deviousprophet/Smarthome_Zigbee/BaoCao/pictures/hub.jpg

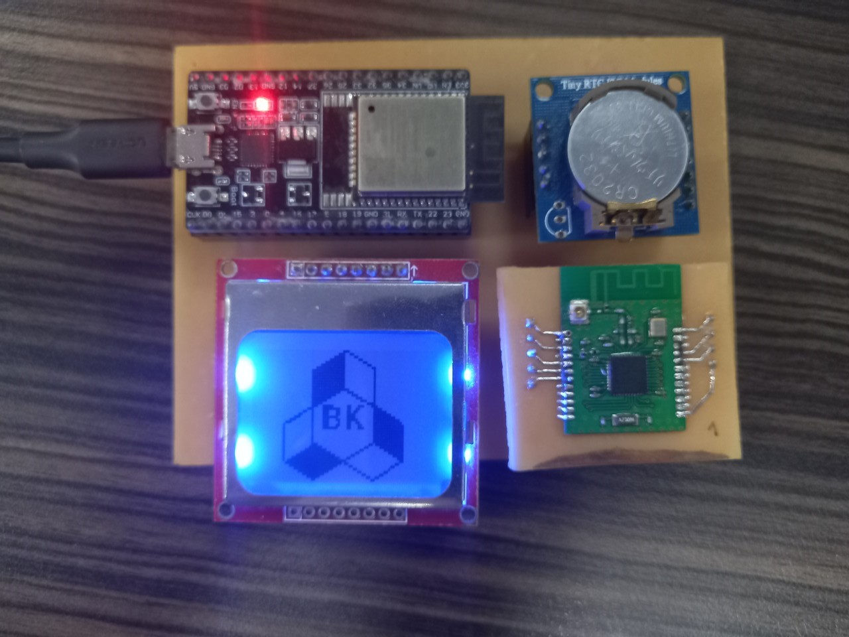
BaoCao/pictures/hub.jpg
