deviousprophet/Smarthome_Zigbee/BaoCao/pictures/relay3.jpg

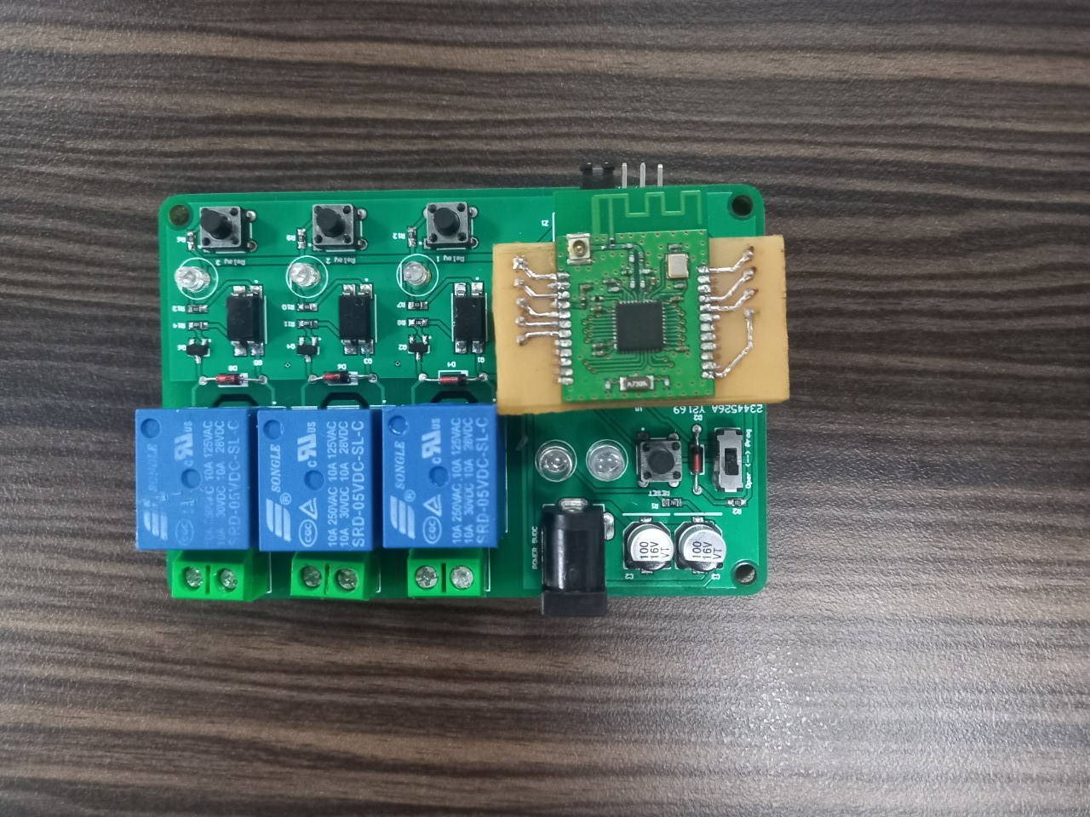
BaoCao/pictures/relay3.jpg
