deviousprophet/Smarthome_Zigbee/pcb/sz1v5/sz1v5_pinout.pdf

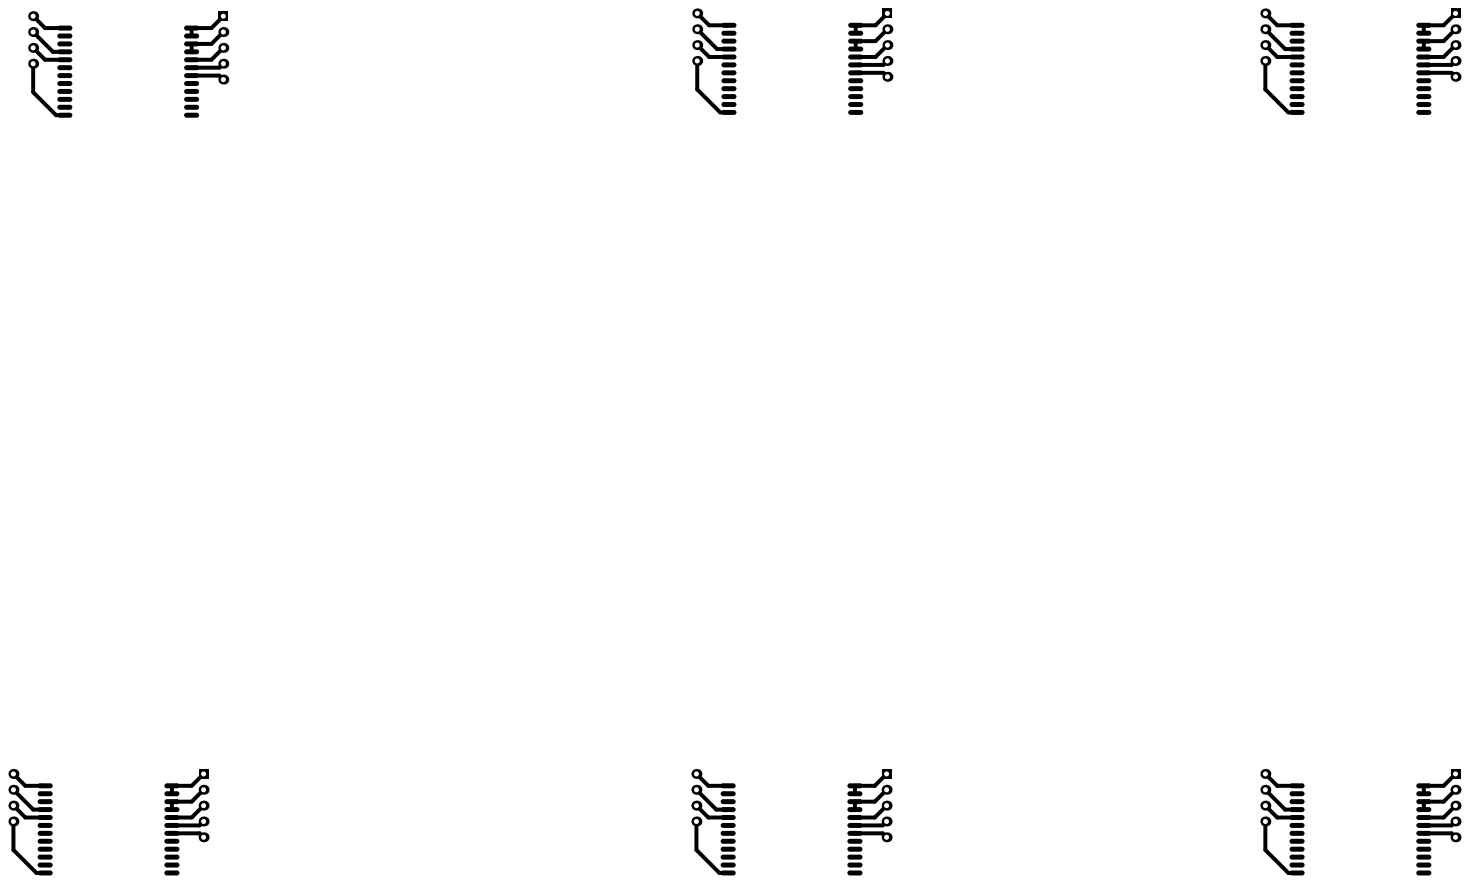
[picture p3: page 1]
