deviousprophet/Smarthome_Zigbee/BaoCao/pictures/button.jpg

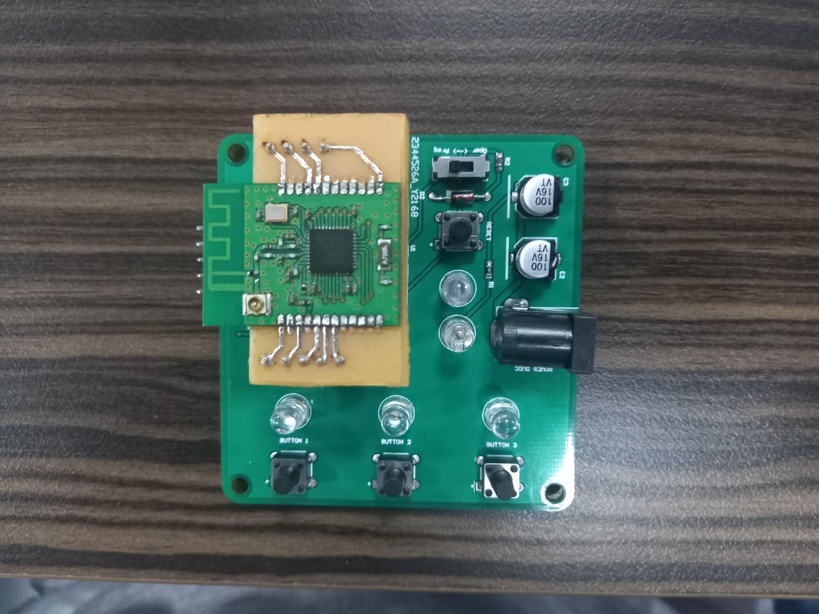
BaoCao/pictures/button.jpg
