deviousprophet/Smarthome_Zigbee/BaoCao/pictures/relay_ade.jpg

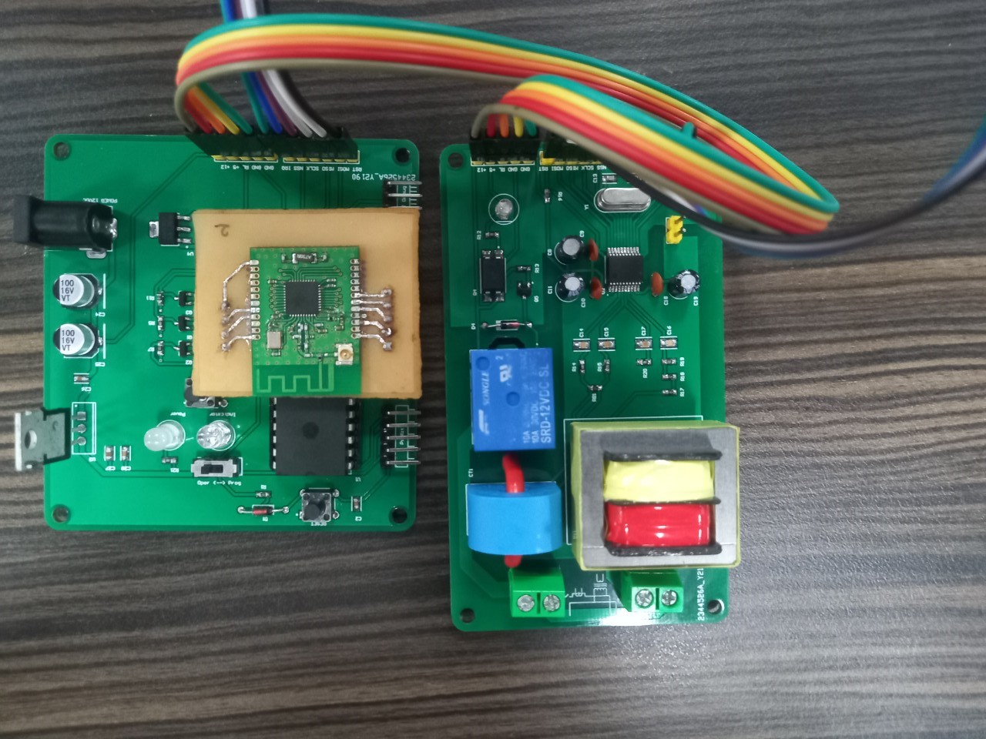
BaoCao/pictures/relay_ade.jpg
