deviousprophet/Smarthome_Zigbee/BaoCao/pictures/sensor.jpg

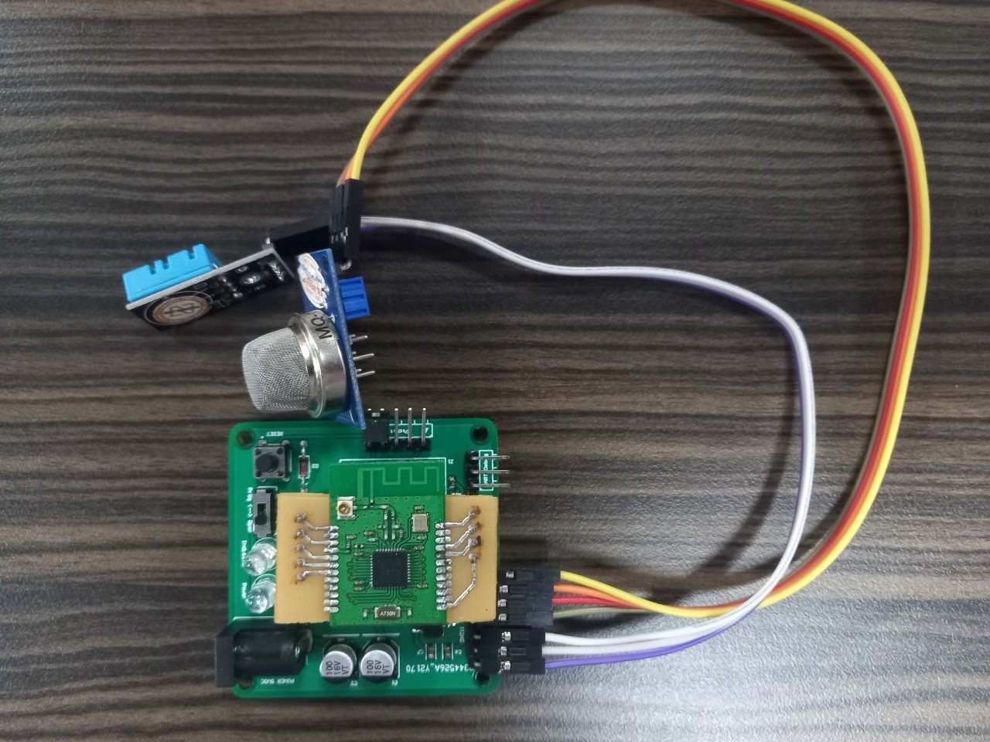
BaoCao/pictures/sensor.jpg
