deviousprophet/Smarthome_Zigbee/source/calibration.xlsx

Sheet: vrms
V1 | 73232 | 25.1 | Vrms1 |  |  | 10632 | 0.204
V2 | 709708 | 249.9 | Vrms2 |  | I1 | 235678 | 4.49 | rms1
VRMSOS | 0.7651600375
IRMSOS | -1.796884521e-08
 |  |  | <200 | >= 200 |  | 0.0003435000542 | -0.7331922115 |  | 2911.207692
ade | MFM383A |  | 0.0003416507375 | 0.0003461786731 |  | 0.0003780683047 | -20.25007624 |  | 2645.024689
292308 | 99.9 | 0.0003417627981 |  |  | 99.86724377 | 0.03278901776 |  | 99.67462163 | 0.2256039729
351490 | 119.9 | 0.0003411192353 |  |  | 120.0868177 | 0.1558112734 |  | 120.0036418 | 0.08644023238
411180 | 140.3 | 0.000341213094 |  |  | 140.4799502 | 0.1282610385 |  | 140.5071601 | 0.1476550775
468181 | 159.9 | 0.0003415345774 |  |  | 159.9543839 | 0.03401120953 |  | 160.0870067 | 0.1169522596
525941 | 180.2 | 0.0003426239825 |  |  | 179.6881305 | 0.2840563147 |  | 179.9275698 | 0.1511821346
583004 | 200.4 | 0.0003437369212 |  |  | 201.8235511 | 0.710354851 |  | 200.1652577 | 0.1171369002
612079 | 211.1 | 0.0003448901204 |  |  | 211.888696 | 0.3736125254 |  | 211.1575936 | 0.02728261973
635744 | 219.8 | 0.0003457366487 |  |  | 220.0810143 | 0.127850018 |  | 220.10458 | 0.1385714469
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
