deviousprophet/Smarthome_Zigbee/BaoCao/ThamKhao/iHome/LVTN.pdf

# TÌM HIỂU, THIẾT KẾ VÀ THI

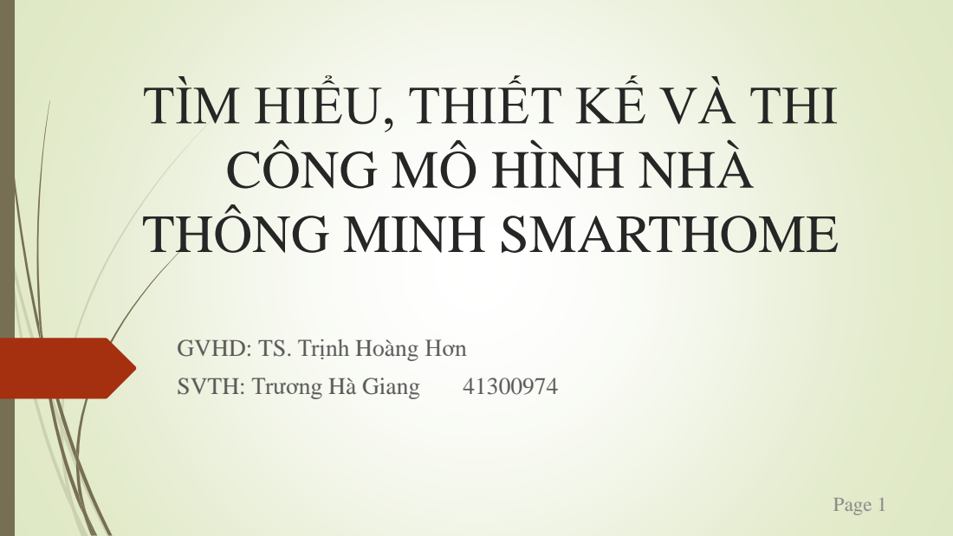
[picture p97: page 1]
SVTH: Trương Hà Giang

CÔNG MÔ HÌNH NHÀ
THÔNG MINH SMARTHOME

GVHD: TS. Trịnh Hoàng Hơn

# Nội dung

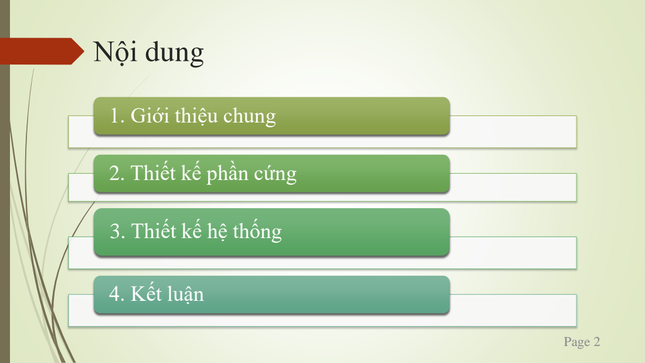
[picture p98: page 2]
4. Kết luận

1. Giới thiệu chung

2. Thiết kế phần cứng

3. Thiết kế hệ thống

## Giới thiệu chung

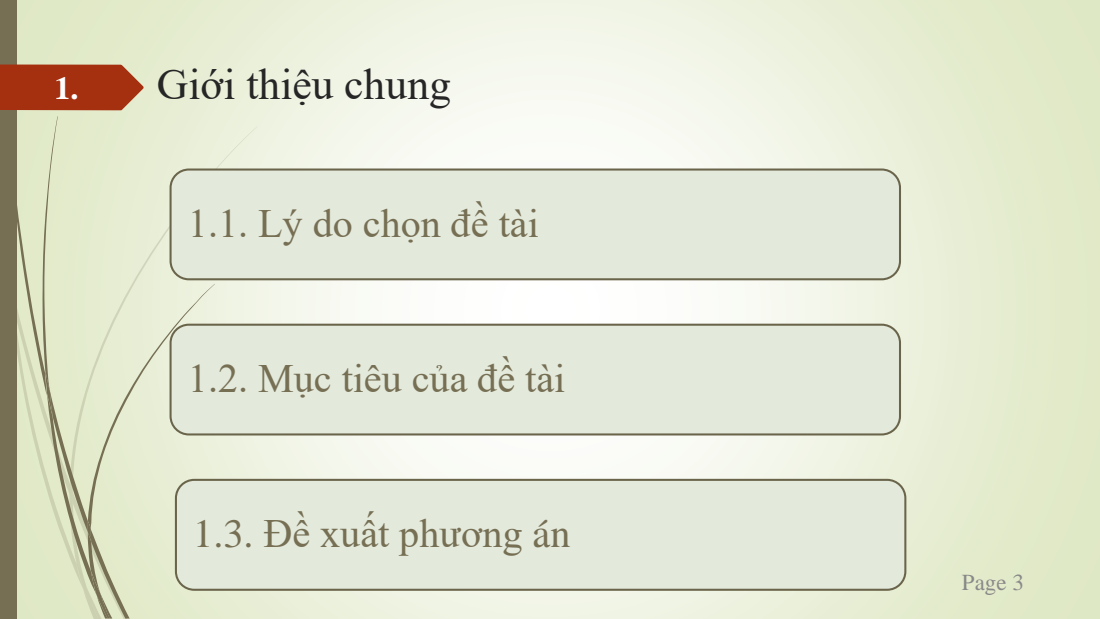
[picture p99: page 3]

1.1. Lý do chọn đề tài

1.2. Mục tiêu của đề tài

1.3. Đề xuất phương án

## 1.1. Lý do chọn đề tài

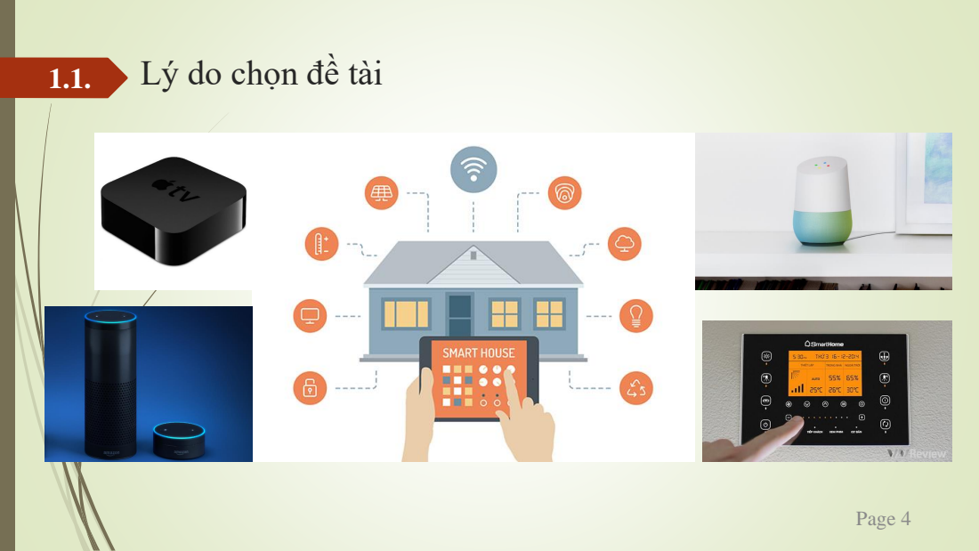
[picture p100: page 4]

## 1.2. Mục tiêu của đề tài

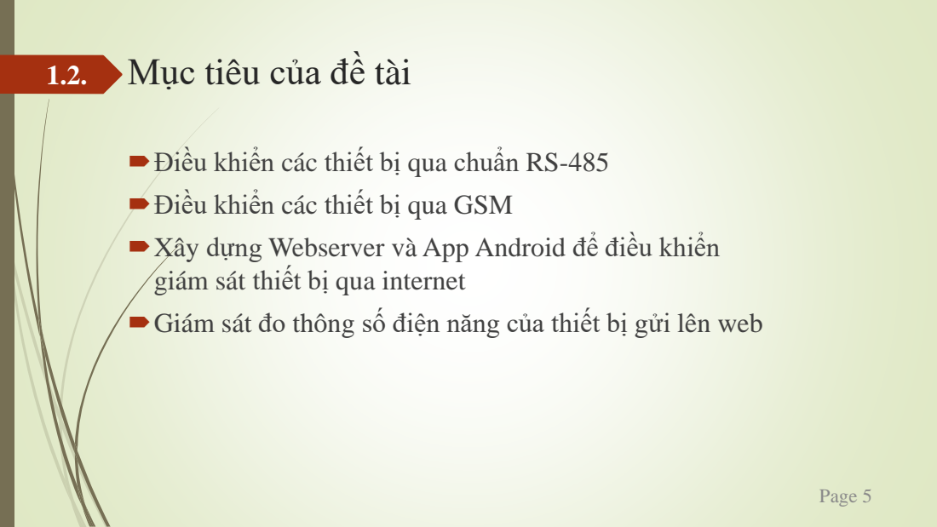
[picture p101: page 5]

Điều khiển các thiết bị qua chuẩn RS-485
Điều khiển các thiết bị qua GSM
Xây dựng Webserver và App Android để điều khiển
giám sát thiết bị qua internet
Giám sát đo thông số điện năng của thiết bị gửi lên web

## 1.3. Đề xuất phương án

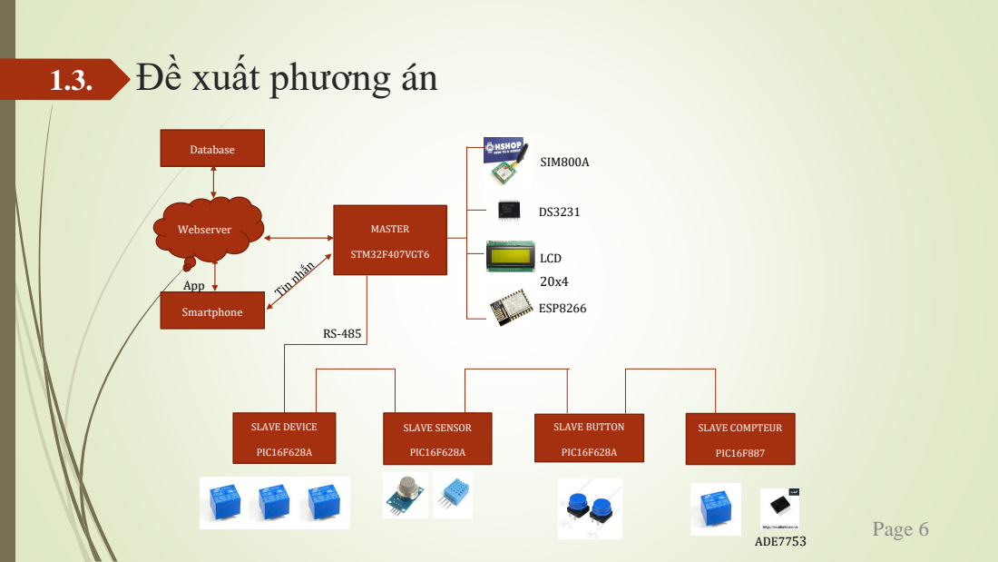
[picture p102: page 6]
ADE7753; SIM800A; LCD; ESP8266; MASTER; STM32F407VGT6; SLAVE BUTTON; PIC16F628A; SLAVE DEVICE; SLAVE SENSOR; SLAVE COMPTEUR; PIC16F887; Webserver; Database; Smartphone; App

## 2. Thiết kế phần cứng

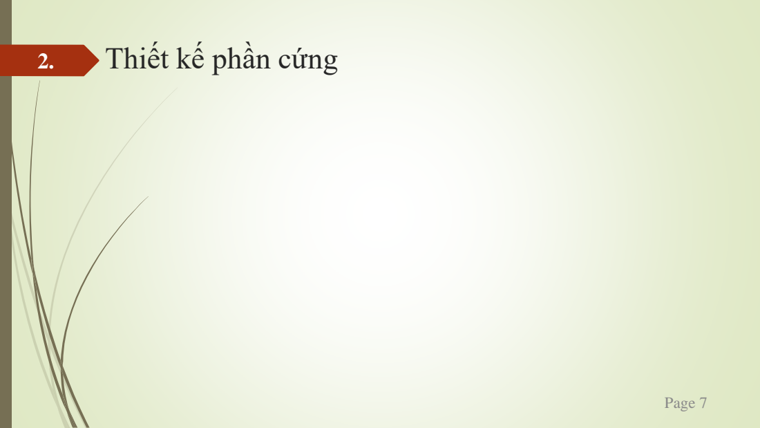
[picture p103: page 7]

## 2.1. Thiết kế mạch Master

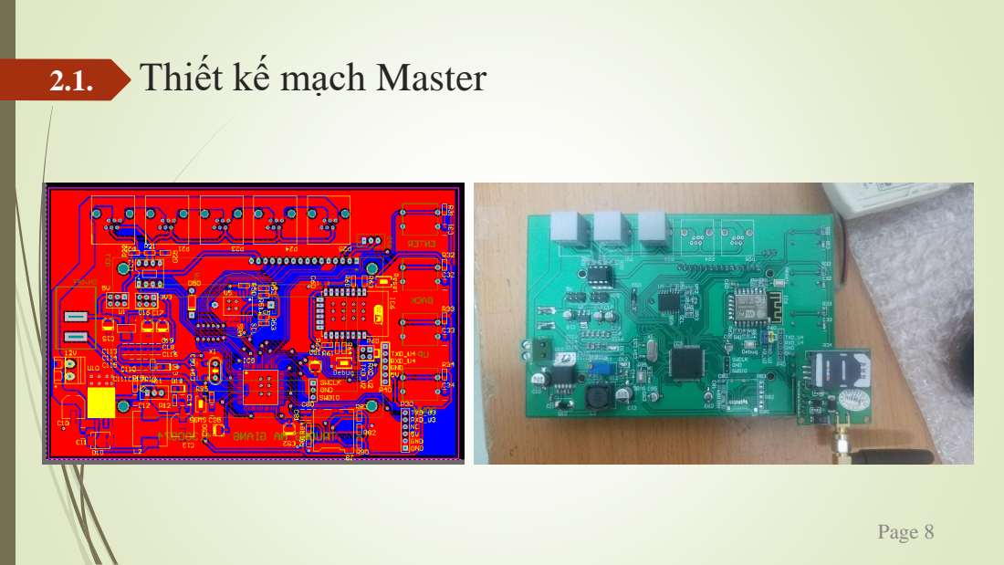
[picture p104: page 8]

## 2.2. Thiết kế mạch Slave Button

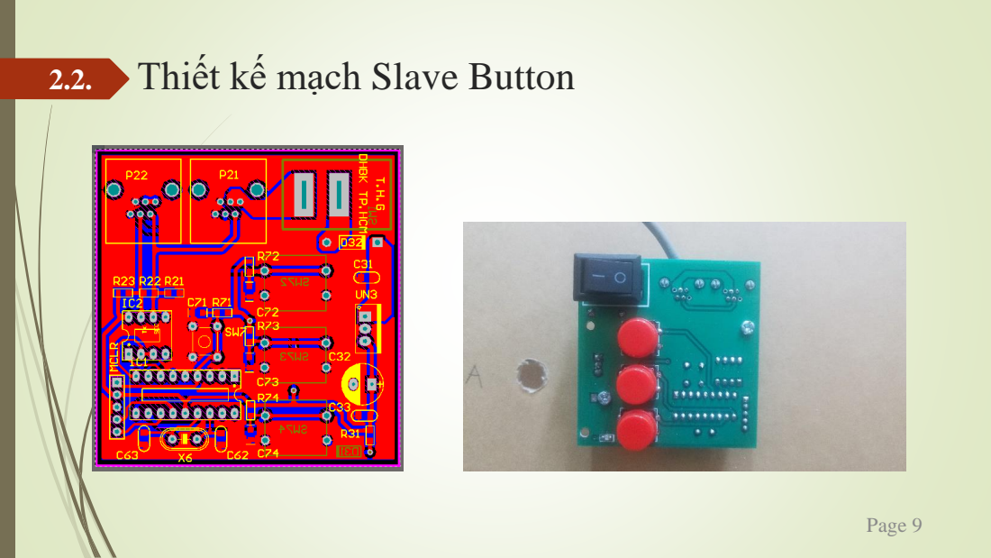
[picture p105: page 9]

## 2.3. Thiết kế mạch Slave Device

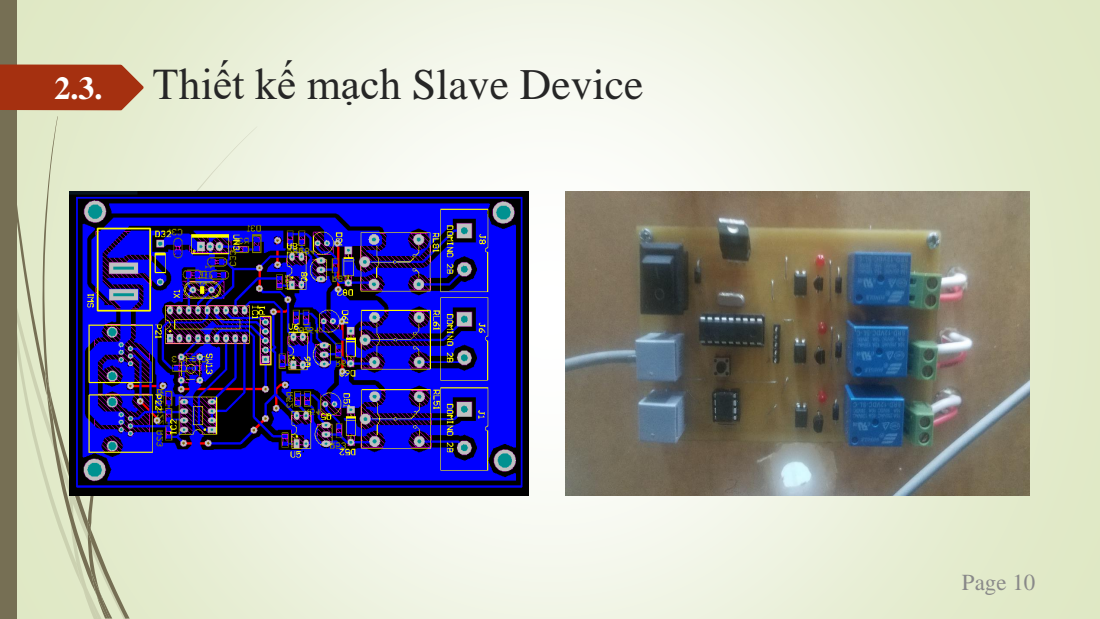
[picture p106: page 10]

## 2.5. Thiết kế mạch Slave Compteur

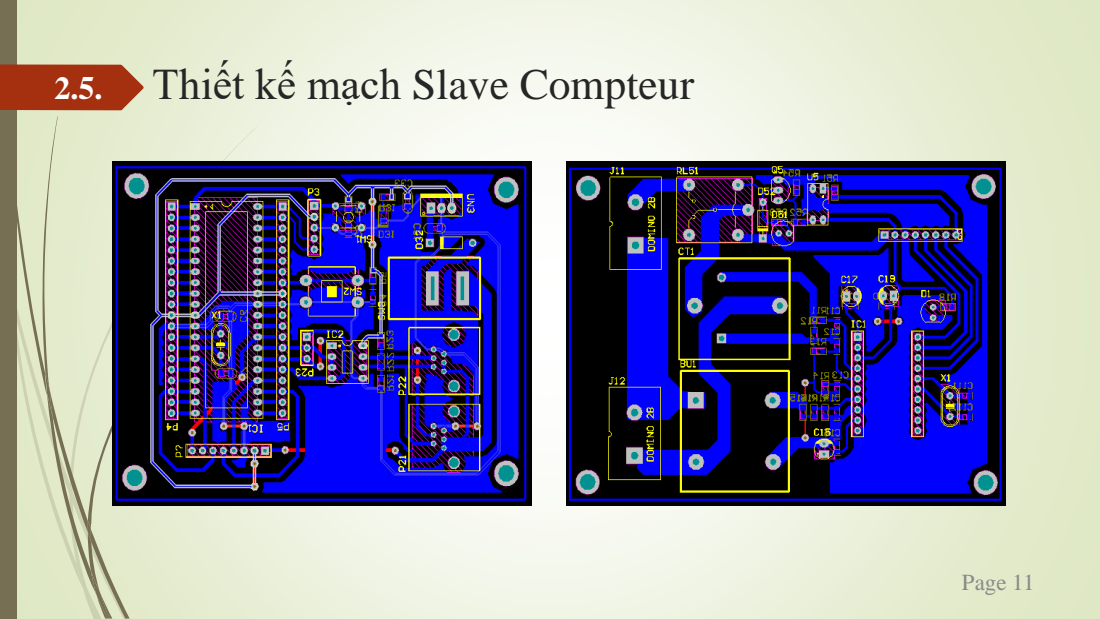
[picture p107: page 11]

## 2.5. Thiết kế mạch Slave Compteur

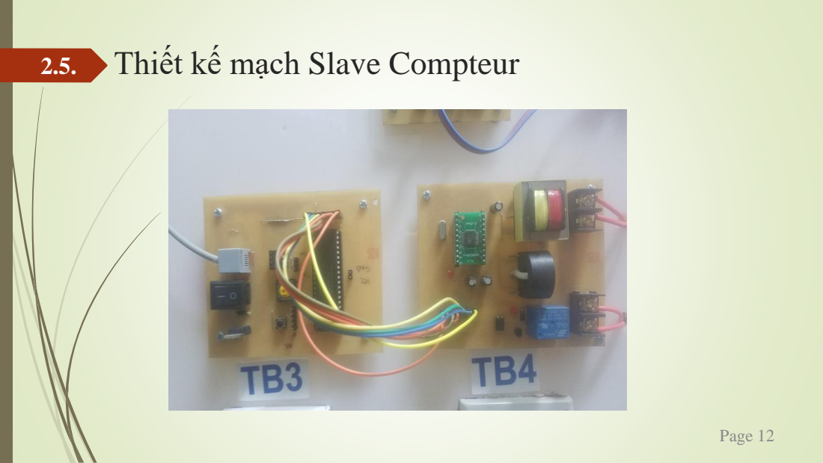
[picture p108: page 12]

## 2.4. Thiết kế mạch Slave Sensor

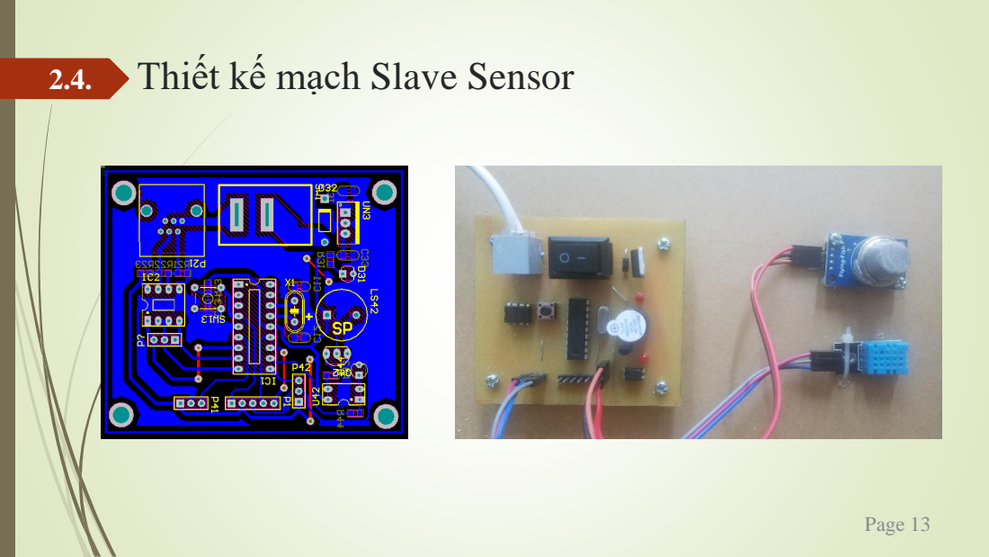
[picture p109: page 13]

## 2.4. Thiết kế mạch Camera

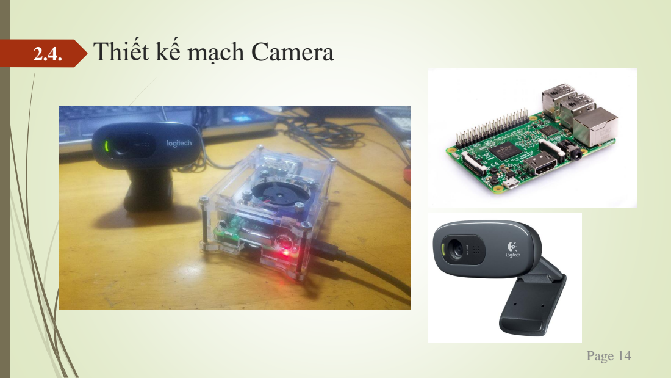
[picture p110: page 14]

## 3. Thiết kế hệ thống

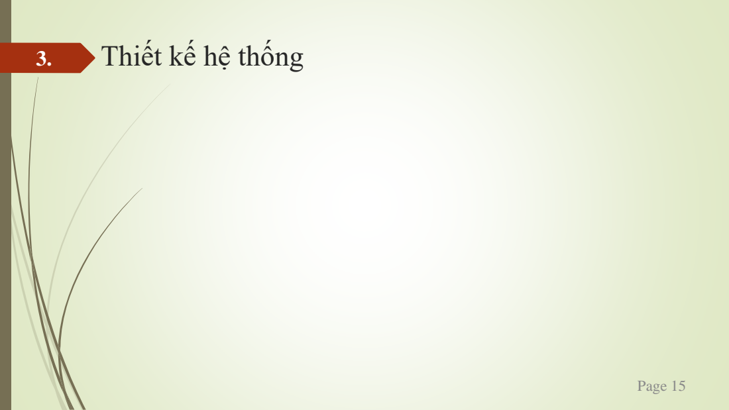
[picture p111: page 15]

## 3.1. Thiết kế giao thức truyền thông

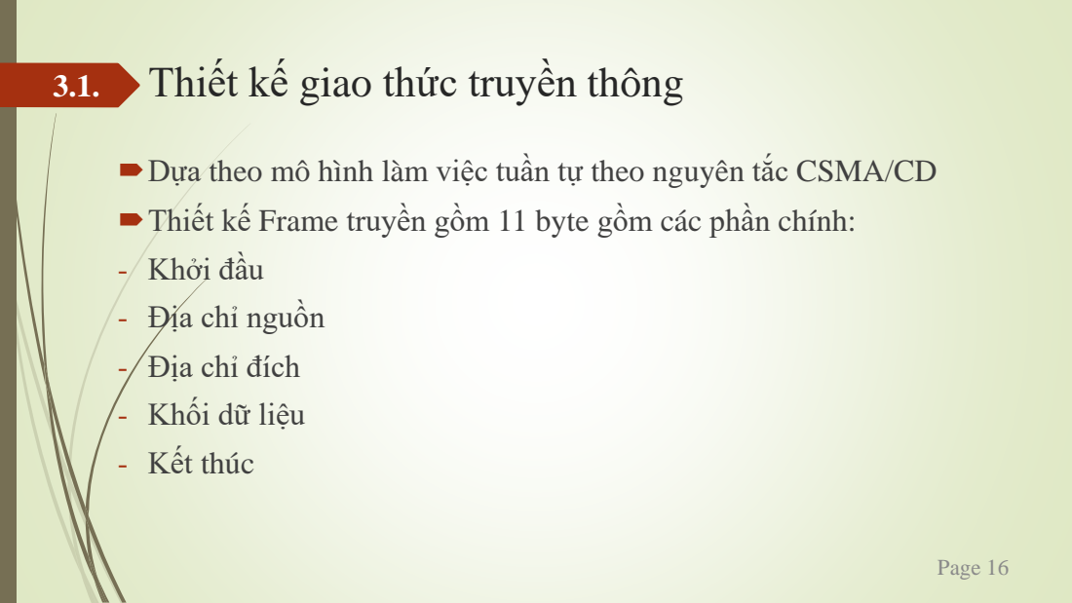
[picture p112: page 16]

Dựa theo mô hình làm việc tuần tự theo nguyên tắc CSMA/CD
Thiết kế Frame truyền gồm 11 byte gồm các phần chính:
- Khởi đầu
- Địa chỉ nguồn

- Địa chỉ đích
- Khối dữ liệu
- Kết thúc

## 3.2. Thiết kế Webserver

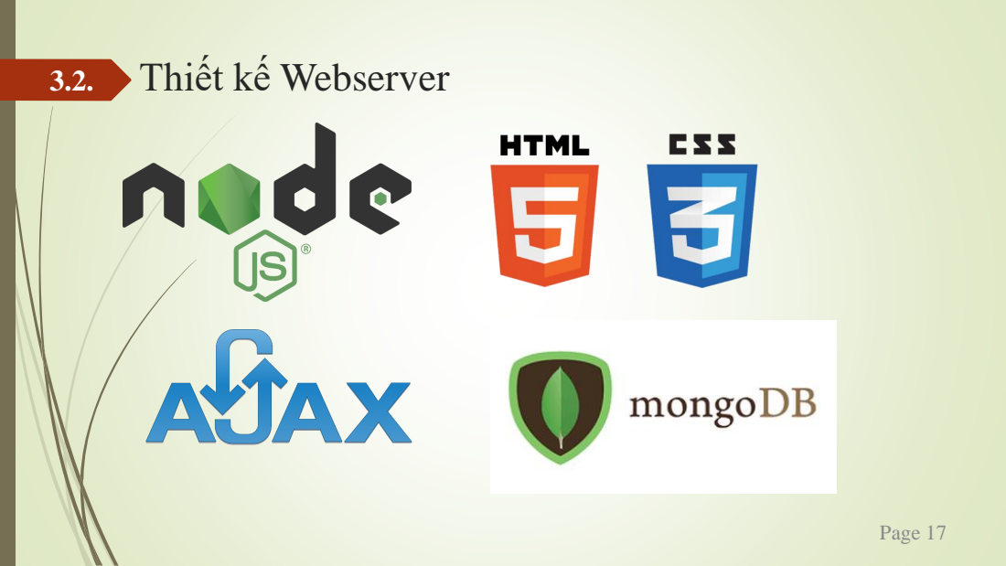
[picture p113: page 17]

## 3.3. Thiết kế Webserver

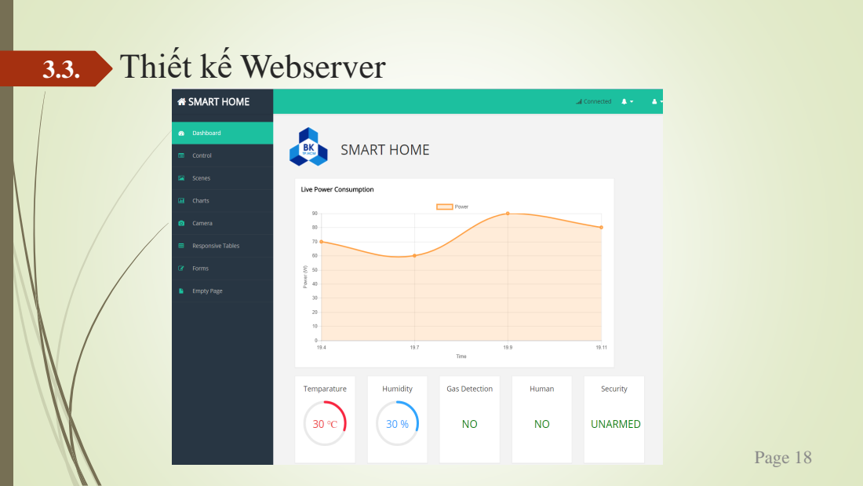
[picture p114: page 18]

## 3.4. Thiết kế App Android

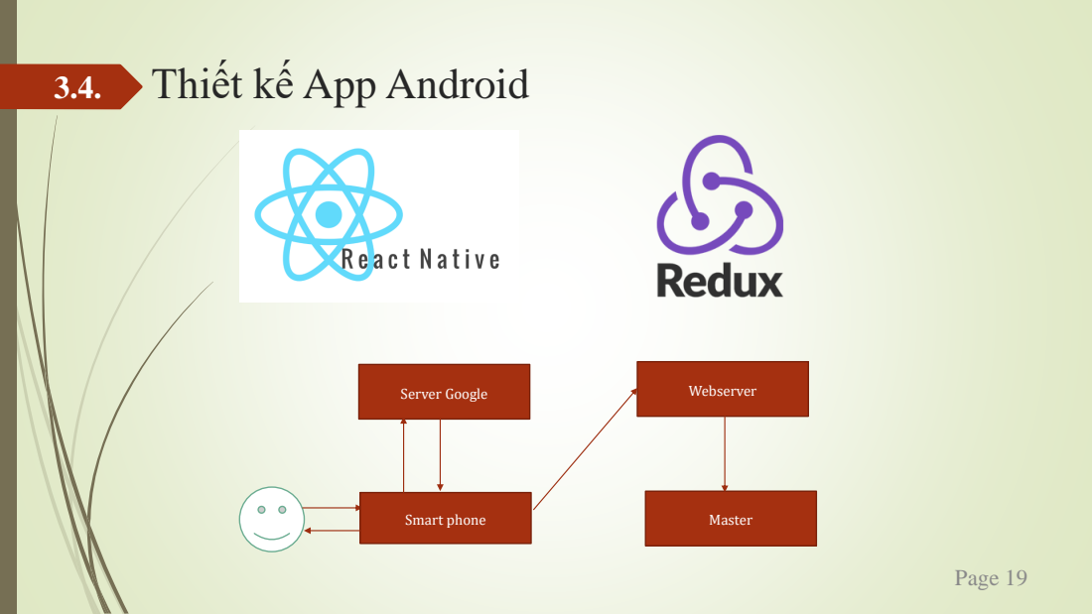
[picture p115: page 19]
Smart phone; Master; Server Google; Webserver

## 3.4. Thiết kế App Android

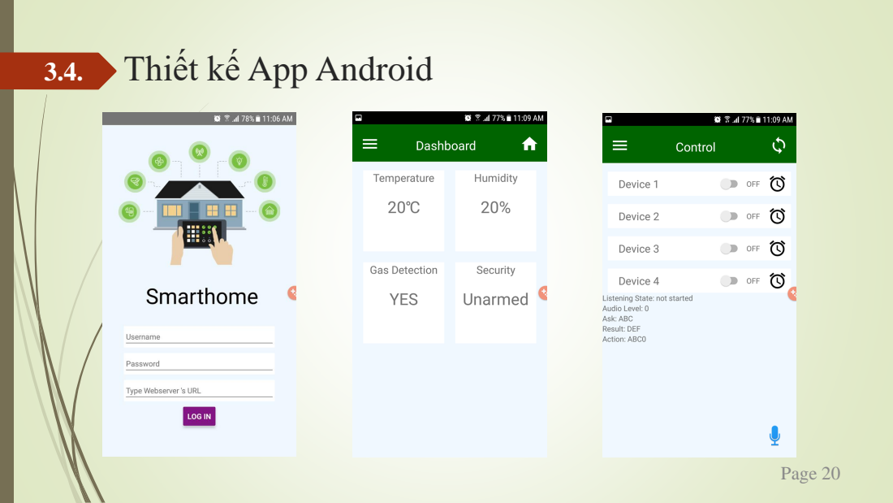
[picture p116: page 20]

## 3.5. Hiệu chỉnh phép đo các thông số điện năng

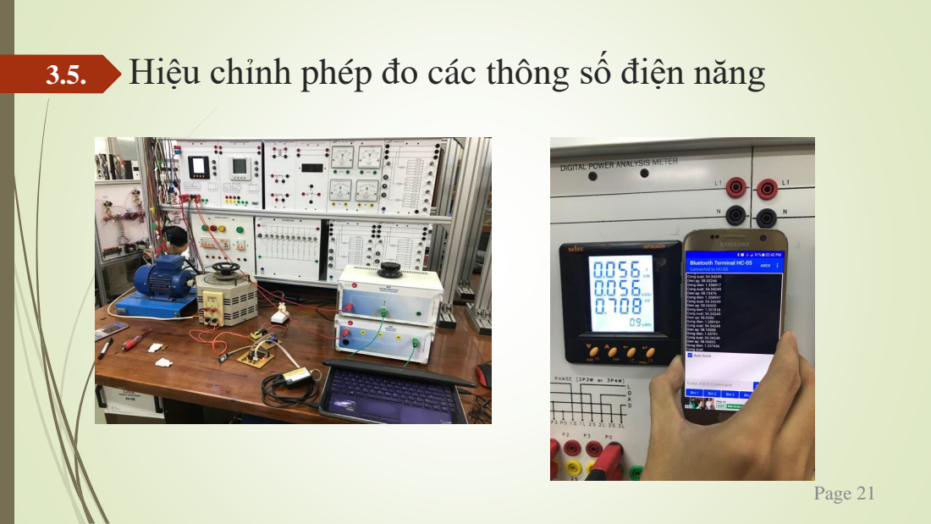
[picture p117: page 21]

## 4. Kết luận

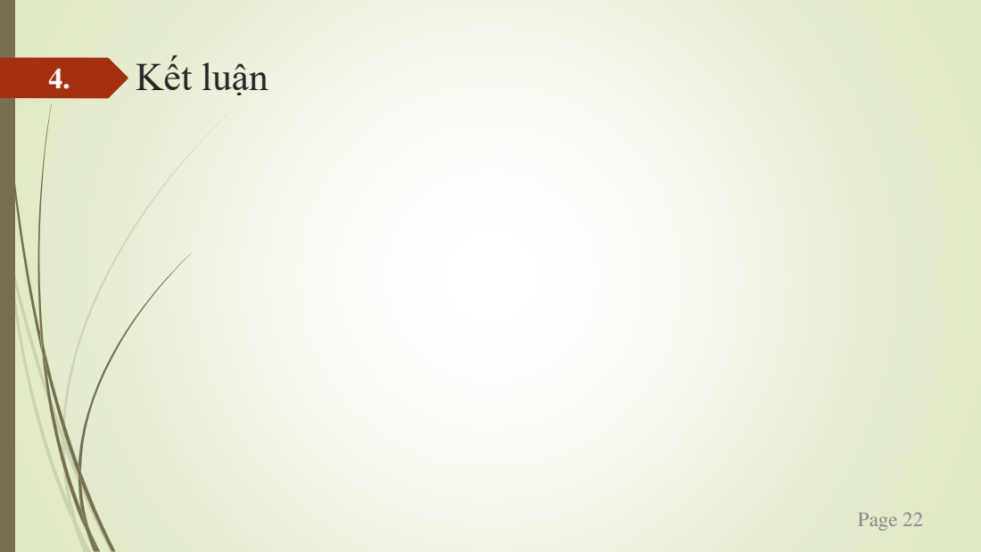
[picture p118: page 22]

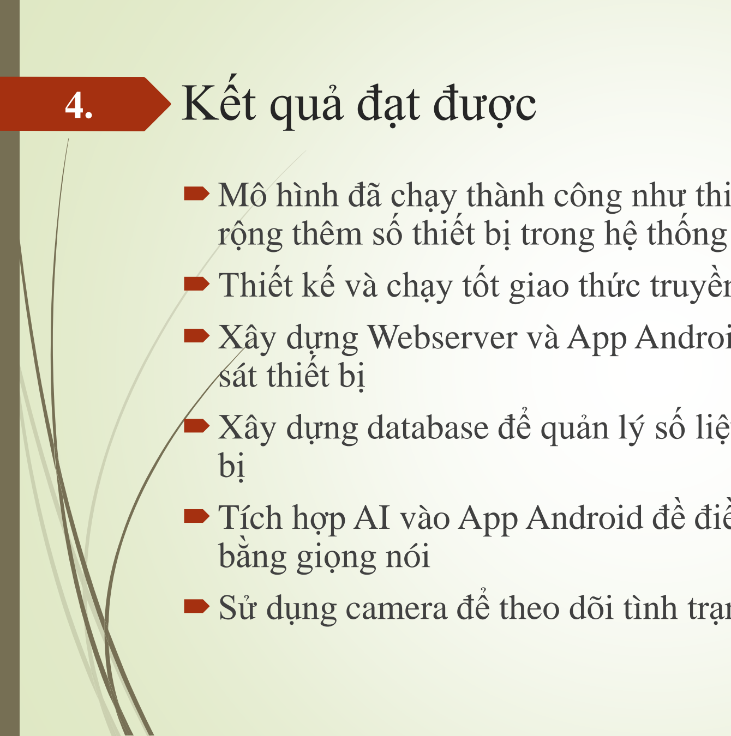
[picture p119: figure]
4. Kết quả đạt được; rộng thêm số thiết bị trong hệ thống; sát thiết bị; bằng giọng nói

Mô hình đã chạy thành công như thiết kế và có khả năng mở

Thiết kế và chạy tốt giao thức truyền thông
Xây dựng Webserver và App Android để điều khiển và giám

Xây dựng database để quản lý số liệu công suất gửi về từ thiết

Tích hợp AI vào App Android đề điều khiển được thiết bị

Sử dụng camera để theo dõi tình trạng căn nhà trên webserver

## 4. Hạn chế

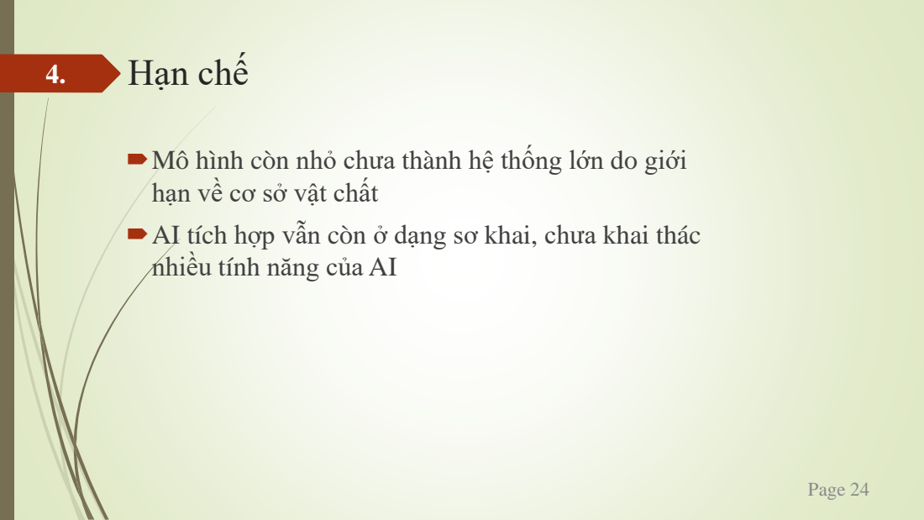
[picture p120: page 24]

Mô hình còn nhỏ chưa thành hệ thống lớn do giới
hạn về cơ sở vật chất
AI tích hợp vẫn còn ở dạng sơ khai, chưa khai thác
nhiều tính năng của AI

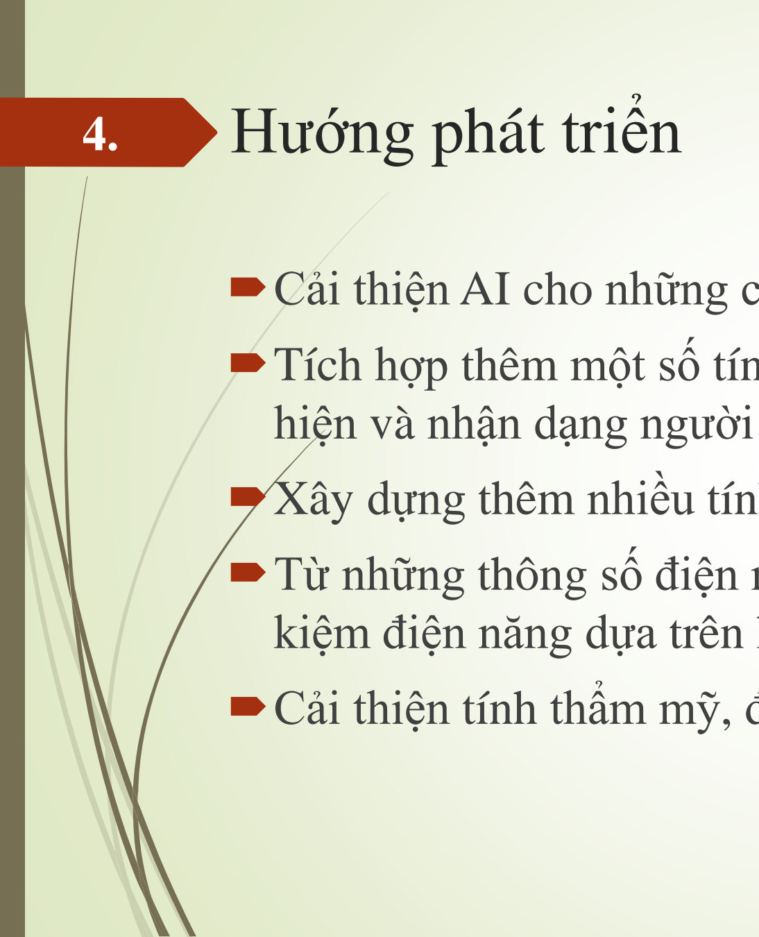
[picture p121: figure]
4. Hướng phát triển; hiện và nhận dạng người

Cải thiện AI cho những chức năng phức tạp hơn
Tích hợp thêm một số tính năng vào camera như phát

Xây dựng thêm nhiều tính năng vào mô hình smarthome Từ những thông số điện năng đưa ra lời khuyên giúp tiết kiệm điện năng dựa trên hành vi của con người
Cải thiện tính thẩm mỹ, độ bền của thiết bị

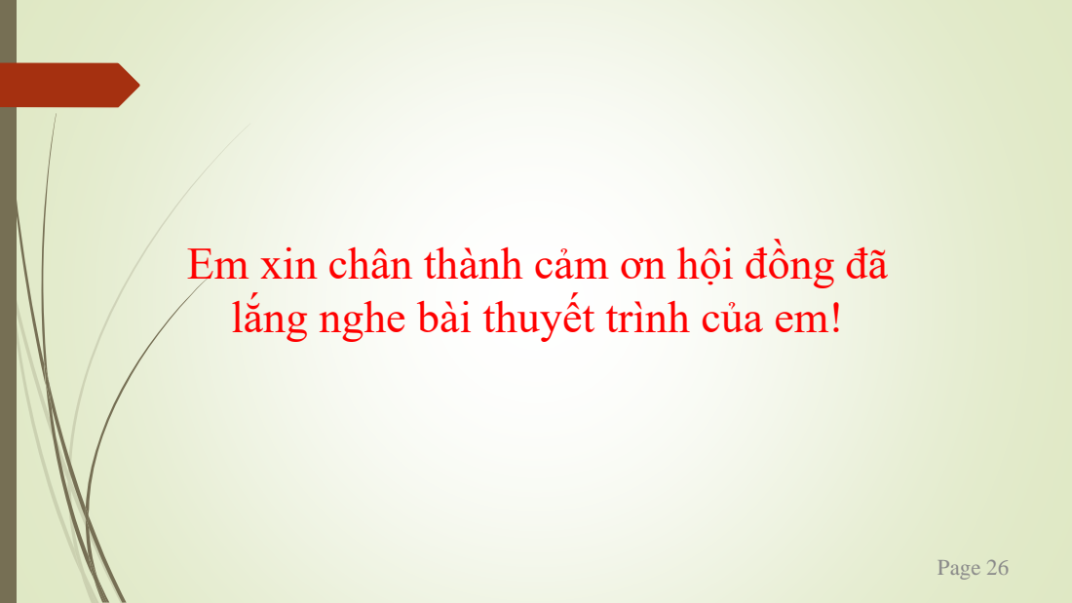
[picture p122: page 26]

Em xin chân thành cảm ơn hội đồng đã
lắng nghe bài thuyết trình của em!

## 5. Trả lời câu hỏi

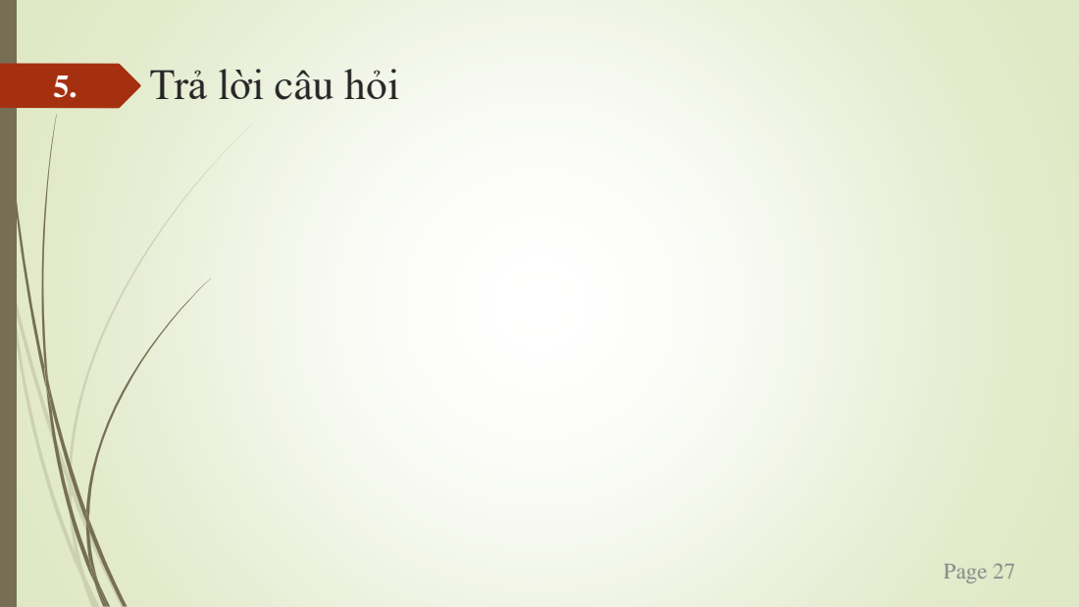
[picture p123: page 27]

5.

| Modbus | Profibus | Giao thức tự đề xuất
Cơ chế | Cơ chế chủ/tớ (Master/Slave), trong đó chỉ một thiết bị có thể chủ động gửi yêu cầu, còn lại các thiết bị tớ sẽ đáp ứng bằng dữ liệu trả lại hoặc thực hiện một hành động nhất định theo như yêu cầu | Hai phương pháp truy nhập bus có thể được áp dụng độc lập hoặc kết hợp là Token Passing và Master/Slave (giống Modbus) | Cơ chế chủ/ tớ (Master/Slave), nhưng linh động ở chỗ Slave có thể gửi ngược lên cho Master mà không cần được yêu cầu

Frame
truyền

Khởi đầu
Địa chỉ
Mã hàm
Dữ liệu
Kiểm soát lỗi
Kết thúc

Khởi đầu phân biệt các loại khung Chiều dài thông tin
Địa chỉ đích
Địa chỉ nguồn
Khối dữ liệu
Byte điều khiển khung
Byte kiểm soát lỗi
Byte kết thúc

Khởi đầu
Địa chỉ nguồn
Địa chỉ đích
Khối dữ liệu
Kết thúc

Câu 1: So sánh giao thức truyền thông tự đề xuất với các giao thức truyền thông phổ biến dung chuẩn RS485 (Modbus, Profibus)

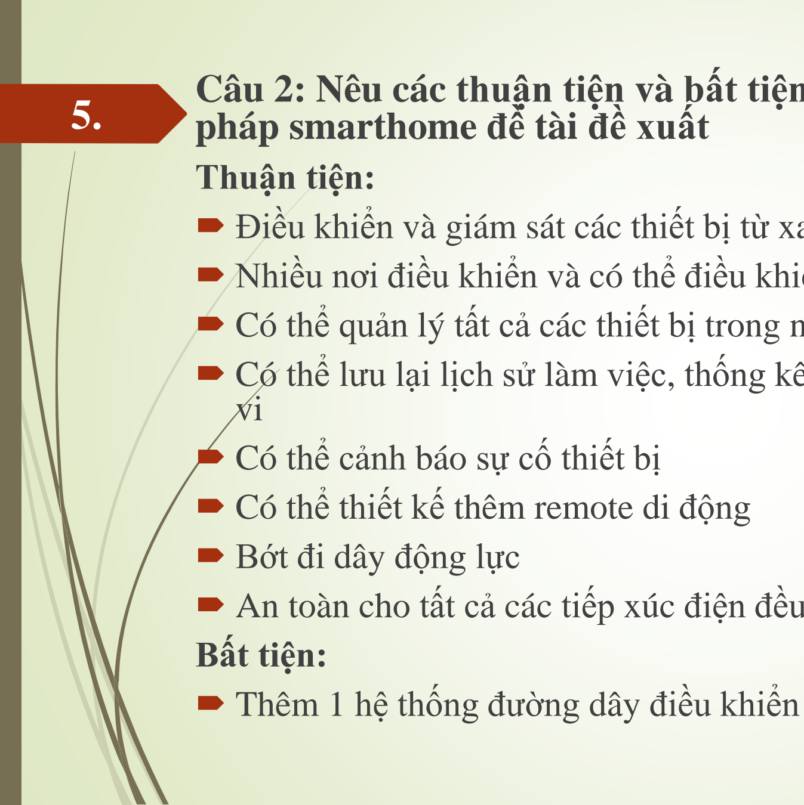
[picture p124: figure]
pháp smarthome đề tài đề xuất; Thuận tiện:; vi Có thể cảnh báo sự cố thiết bị; Có thể thiết kế thêm remote di động; Bớt đi dây động lực; Bất tiện:; Thêm 1 hệ thống đường dây điều khiển

Câu 2: Nêu các thuận tiện và bất tiện khi thiết lập và sử dụng giải

- Điều khiển và giám sát các thiết bị từ xa dễ dàng
- Nhiều nơi điều khiển và có thể điều khiển tập trung
- Có thể quản lý tất cả các thiết bị trong nhà và quản lý qua điện thoại, internet
- Có thể lưu lại lịch sử làm việc, thống kê công suất => tiết kiệm điện qua hành
- An toàn cho tất cả các tiếp xúc điện đều là 12V DC

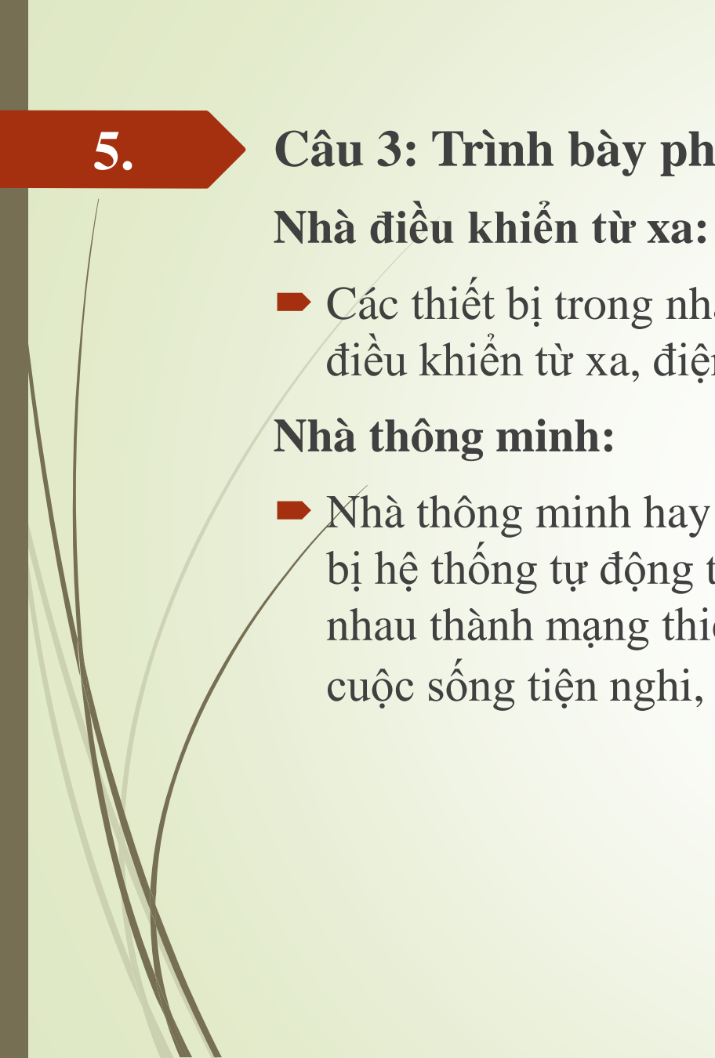
[picture p125: figure]
Nhà điều khiển từ xa:; Nhà thông minh:

Câu 3: Trình bày phân biệt nhà thông minh với nhà điều khiển từ xa

- Các thiết bị trong nhà được chủ nhân điều khiển từ xa thông qua các thiết bị điều khiển từ xa, điện thoại, mạng internet.
- Nhà thông minh hay Smarthome được hiểu là một ngôi nhà/căn hộ được trang bị hệ thống tự động tiên tiến gồm các thiết bị điện tử gia dụng được kết nối với nhau thành mạng thiết bị và hoạt động theo kịch bản tùy biến, nhằm tạo ra cuộc sống tiện nghi, an toàn, tiết kiệm năng lượng.

## Hiệu chỉnh điện áp

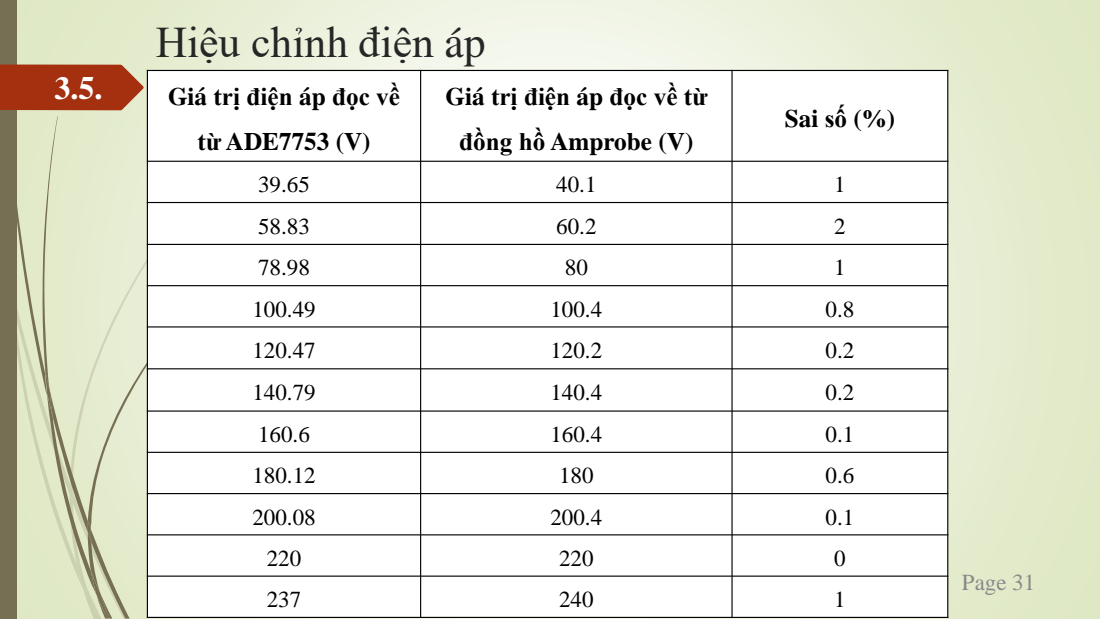
[picture p126: page 31]

Giá trị điện áp đọc về từ ADE7753 (V) | Giá trị điện áp đọc về từ đồng hồ Amprobe (V) | Sai số (%)

## 3.5. Hiệu chỉnh dòng điện

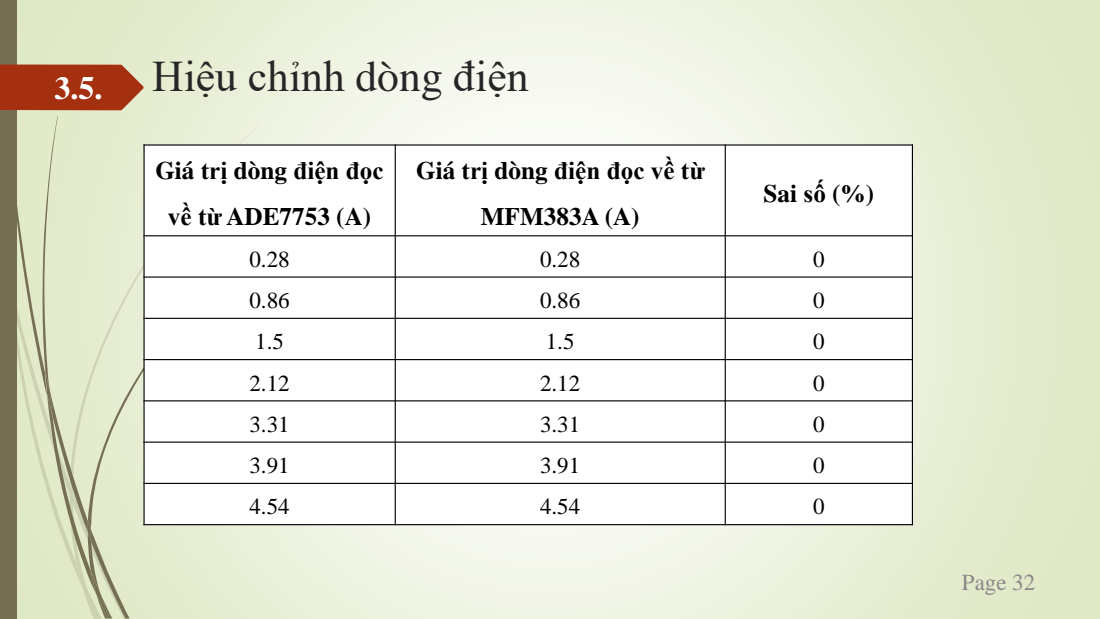
[picture p127: page 32]

Giá trị dòng điện đọc về từ ADE7753 (A) | Giá trị dòng điện đọc về từ MFM383A (A) | Sai số (%)

## 3.5. Hiệu chỉnh công suất với cosθ ≈ 1

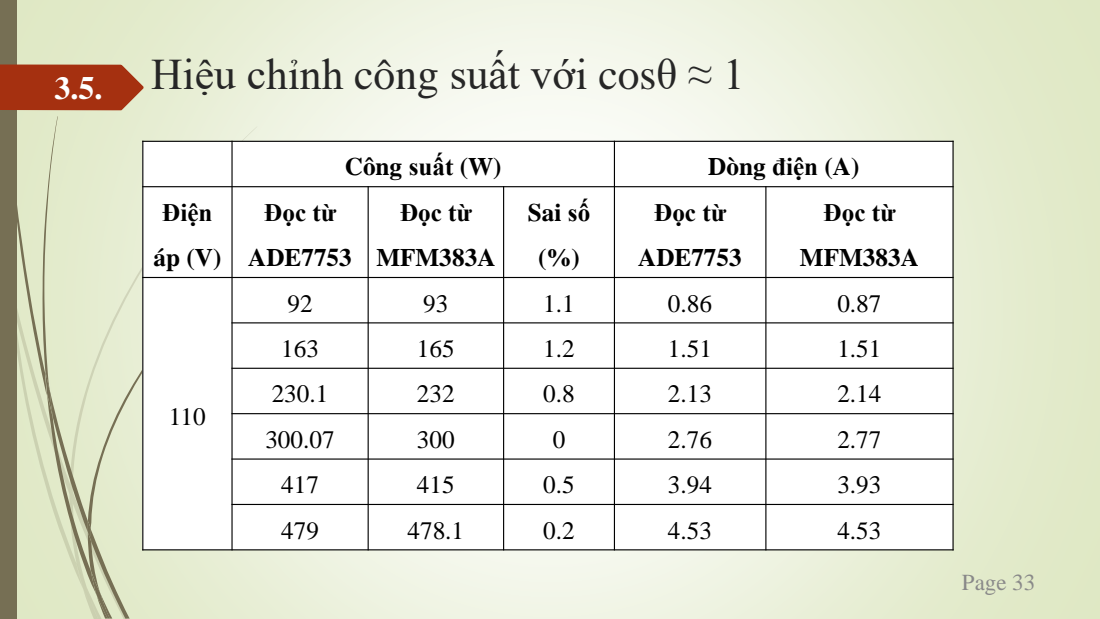
[picture p128: page 33]

Công suất (W) | Dòng điện (A)

Điện áp (V) | Đọc từ ADE7753 | Đọc từ MFM383A | Sai số (%) | Đọc từ ADE7753 | Đọc từ MFM383A

## 3.5. Hiệu chỉnh công suất cosθ ≠ 1

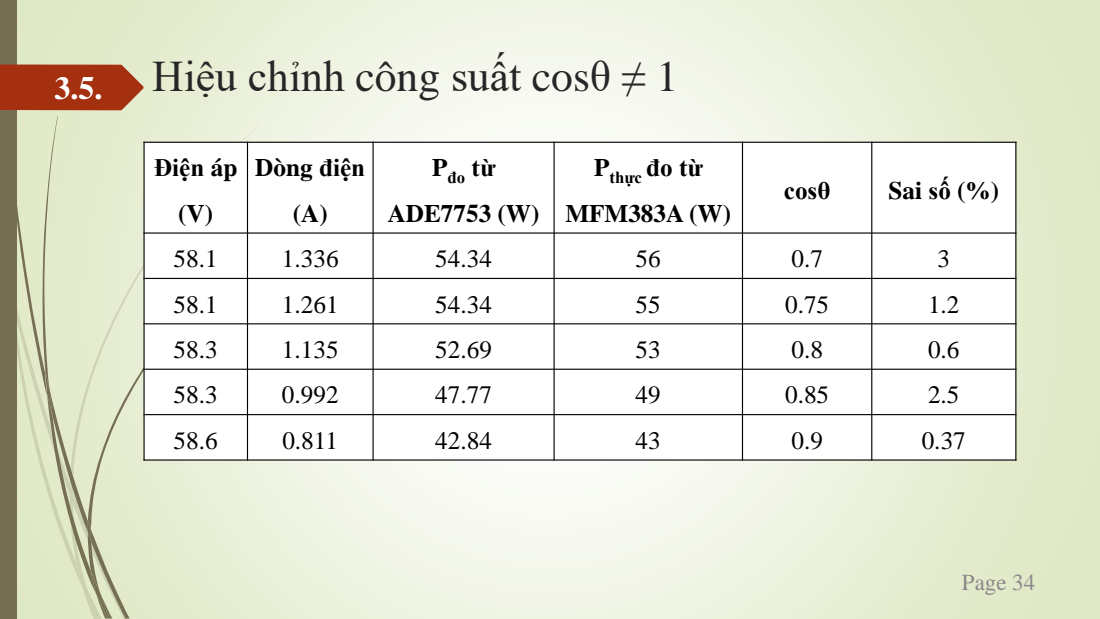
[picture p129: page 34]

Điện áp (V) | Dòng điện (A) | Pđo từ ADE7753 (W) | Pthực đo từ MFM383A (W) | cosθ | Sai số (%)
