deviousprophet/Smarthome_Zigbee/(list of files, drawings)

Other design files:
pcb/AMS1117-Module.PcbLib
pcb/AMS1117-Module.SchLib
pcb/DS1307.PcbLib
pcb/DS1307.SchLib
pcb/LCD5110.PcbLib
pcb/LCD5110.SchLib
pcb/MH-G6.PcbLib
pcb/MH-G6.SchLib
pcb/SZ1V5.PcbLib
pcb/SZ1V5.SchLib
pcb/sz1v5/sz1v5.PcbDoc
pcb/sz1v5/sz1v5.PrjPcb
pcb/sz1v5/sz1v5.SchDoc
pcb/zb_button/zb_button.PcbDoc
pcb/zb_button/zb_button.PrjPcb
pcb/zb_button/zb_button.SchDoc
pcb/zb_hub/zb_hub.PcbDoc
pcb/zb_hub/zb_hub.PrjPcb
pcb/zb_hub/zb_hub.SchDoc
pcb/zb_relay/relay_button.SchDoc
pcb/zb_relay/zb_16f628a.SchDoc
pcb/zb_relay/zb_relay.PcbDoc
pcb/zb_relay/zb_relay.PrjPcb
pcb/zb_relay_ade/ade7753.SchDoc
pcb/zb_relay_ade/ade7753_relay.PcbDoc
pcb/zb_relay_ade/power_supply.SchDoc
pcb/zb_relay_ade/zb_16f887.PcbDoc
pcb/zb_relay_ade/zb_ade7753.PrjPcb
pcb/zb_relay_ade/zb_pic16f887.SchDoc
pcb/zb_sensor/zb_sensor.PcbDoc
pcb/zb_sensor/zb_sensor.PrjPcb
pcb/zb_sensor/zb_sensor.SchDoc
pcb/ZMCT103C.PcbLib
pcb/ZMCT103C.SchLib
pcb/ZN28120BA1.PcbLib
pcb/ZN28120BA1.SchLib
